kamocat/fast_charge/README.md

# fast_charge
A flexible buck buck converter for fast charging cell phones from unreliable power sources
