kamocat/fast_charge/digikey cart.xlsx

Index | Quantity | Part Number | Manufacturer Part Number | Description | Customer Reference | Available | Backorder | Unit Price | Extended Price USD
1 | 20 | RMCF0603FT30K1CT-ND | RMCF0603FT30K1 | RES 30.1K OHM 1% 1/10W 0603 |  | 20 | 0 | 0.015 | 0.30
2 | 10 | RMCF0603FT31K6CT-ND | RMCF0603FT31K6 | RES 31.6K OHM 1% 1/10W 0603 |  | 10 | 0 | 0.015 | 0.15
3 | 10 | RMCF0603FT42K2CT-ND | RMCF0603FT42K2 | RES 42.2K OHM 1% 1/10W 0603 |  | 10 | 0 | 0.015 | 0.15
4 | 10 | RMCF0603FT15K8CT-ND | RMCF0603FT15K8 | RES 15.8K OHM 1% 1/10W 0603 |  | 10 | 0 | 0.015 | 0.15
5 | 20 | RMCF0603FT158KCT-ND | RMCF0603FT158K | RES 158K OHM 1% 1/10W 0603 |  | 20 | 0 | 0.015 | 0.30
6 | 3 | 31-AP63300WU-7CT-ND | AP63300WU-7 | IC REG BUCK ADJ 3A TSOT26 |  | 3 | 0 | 0.92 | 2.76
7 | 3 | 3757-TS360ILS_R1_00001CT-ND | TS360ILS_R1_00001 | MICRO SURFACE MOUNT SCHOTTKY BRI |  | 3 | 0 | 0.58 | 1.74
8 | 15 | 4713-GMC31X7R106K50NTCT-ND | GMC31X7R106K50NT | CAP1206 X7R 10UF 10% 50V |  | 15 | 0 | 0.216 | 3.24
9 | 10 | 4816-HPC6045NC-3R3MCT-ND | HPC 6045NC-3R3M | 3.3 UH SHIELDED DRUM CORE, WIREW |  | 10 | 0 | 0.161 | 1.61
10 | 10 | RMCF0603FT390KCT-ND | RMCF0603FT390K | RES 390K OHM 1% 1/10W 0603 |  | 10 | 0 | 0.015 | 0.15
11 | 10 | RMCF0603FT4K53CT-ND | RMCF0603FT4K53 | RES 4.53K OHM 1% 1/10W 0603 |  | 10 | 0 | 0.015 | 0.15
12 | 10 | 13-PA0805FRF870R005LCT-ND | PA0805FRF870R005L | RES 0.005 OHM 1% 1W 0805 |  | 10 | 0 | 0.254 | 2.54
13 | 10 | RMCF0603FT17K4CT-ND | RMCF0603FT17K4 | RES 17.4K OHM 1% 1/10W 0603 |  | 10 | 0 | 0.015 | 0.15
14 | 10 | RMCF0603FT93K1CT-ND | RMCF0603FT93K1 | RES 93.1K OHM 1% 1/10W 0603 |  | 10 | 0 | 0.015 | 0.15
15 | 3 | 31-AP64060WU-7CT-ND | AP64060WU-7 | IC REG BUCK ADJ 600MA TSOT26 |  | 3 | 0 | 0.62 | 1.86
16 | 4 | 445-6762-1-ND | MLZ2012N100LT000 | FIXED IND 10UH 500MA 300MOHM SMD |  | 4 | 0 | 0.12 | 0.48
