kamocat/fast_charge/fast_charger.kicad_pcb

## KiCad design fast_charger.kicad_pcb (2024-04-20)

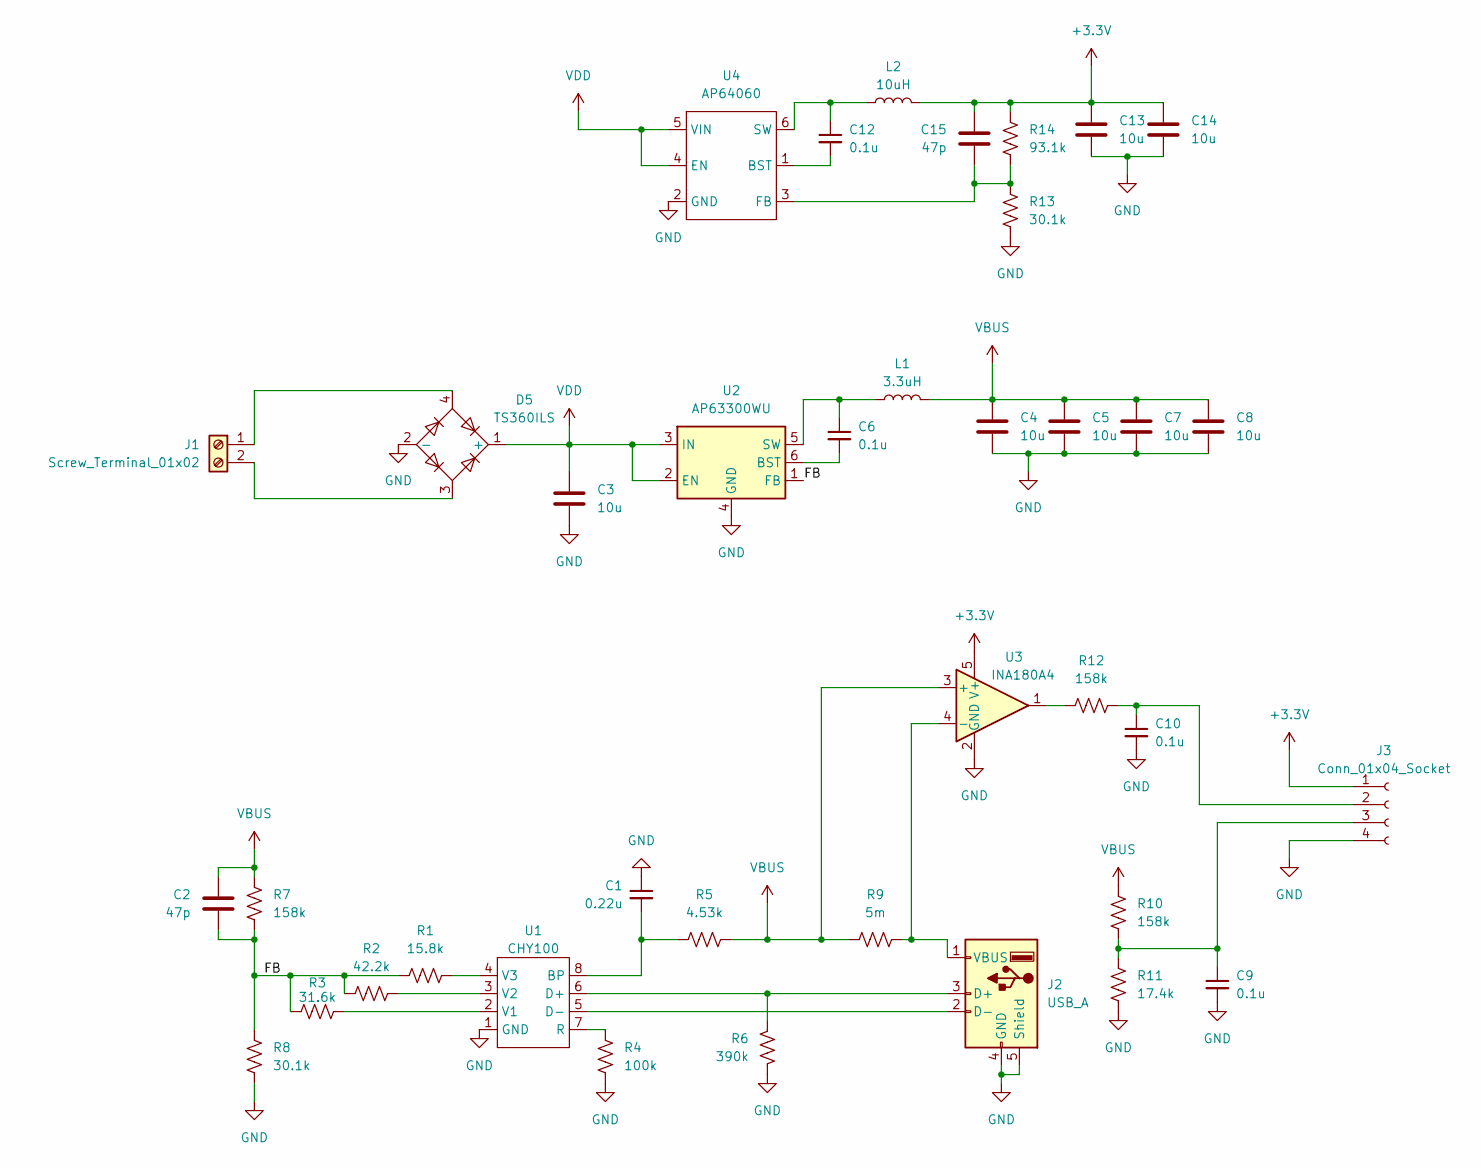
[picture p1: schematic fast_charger.kicad_sch]

Parts:
C1: 0.22u; C_0603_1608Metric
C2, C15: 47p; C_0603_1608Metric
C3, C4, C5, C7, C8: 10u; C_1206_3216Metric
C6, C9, C10, C12: 0.1u; C_0603_1608Metric
C13, C14: 10u; C_0805_2012Metric
D5: TS360ILS; TSSOP-4_4.4x5mm_P4mm
J1: Screw_Terminal_01x02; TerminalBlock_Phoenix_MKDS-3-2-5.08_1x02_P5.08mm_Horizontal
J2: USB_A; usb_CU01
J3: Conn_01x04_Socket; PinHeader_1x04_P2.54mm_Vertical
L1: 3.3uH; L_6.5x6.5
L2: 10uH; L_0805_2012Metric
R1: 15.8k; R_0603_1608Metric
R2: 42.2k; R_0603_1608Metric
R3: 31.6k; R_0603_1608Metric
R4: 100k; R_0603_1608Metric
R5: 4.53k; R_0603_1608Metric
R6: 390k; R_0603_1608Metric
R7, R10, R12: 158k; R_0603_1608Metric
R8, R13: 30.1k; R_0603_1608Metric
R9: 5m; R_0805_2012Metric
R11: 17.4k; R_0603_1608Metric
R14: 93.1k; R_0603_1608Metric
U1: CHY100; SO-8_3.9x4.9mm_P1.27mm
U2: AP63300WU; TSOT-23-6
U3: INA180A4; SOT-23-5
U4: AP64060; SOT-23-6

Connections:
+3.3V: C13.1, C14.1, C15.1, J3.1, L2.2, R14.1, U3.5 (V+)
/FB: C2.2, R1.1, R2.1, R3.1, R7.2, R8.1, U2.1 (FB)
GND: C1.1, C3.2, C4.2, C5.2, C7.2, C8.2, C9.2, C10.2, C13.2, C14.2, D5.2 (-), J2.4 (GND), J2.5 (Shield), J3.4, R4.2, R6.1, R8.2, R11.1, R13.2, U1.1 (GND), U2.4 (GND), U3.2 (GND), U4.2 (GND)
unnamed: D5.4, J1.1
unnamed: D5.3, J1.2
unnamed: J2.3 (D+), R6.2, U1.6 (D+)
unnamed: J2.2 (D-), U1.5 (D-)
unnamed: J2.1 (VBUS), R9.2, U3.4 (-)
unnamed: C10.1, J3.2, R12.2
unnamed: C9.1, J3.3, R10.2, R11.2
unnamed: R12.1, U3.1
unnamed: C1.2, R5.1, U1.8 (BP)
unnamed: R4.1, U1.7 (R)
unnamed: R3.2, U1.2 (V1)
unnamed: R2.2, U1.3 (V2)
unnamed: R1.2, U1.4 (V3)
unnamed: C6.2, U2.6 (BST)
unnamed: C6.1, L1.1, U2.5 (SW)
unnamed: C12.2, U4.1 (BST)
unnamed: C15.2, R13.1, R14.2, U4.3 (FB)
unnamed: C12.1, L2.1, U4.6 (SW)
VBUS: C2.1, C4.1, C5.1, C7.1, C8.1, L1.2, R5.2, R7.1, R9.1, R10.1, U3.3 (+)
VDD: C3.1, D5.1 (+), U2.2 (EN), U2.3 (IN), U4.4 (EN), U4.5 (VIN)

Board: 2 copper layers, 38 parts (0 on the bottom side), 23 nets, no tracks yet.
