kamocat/fast_charge/(commit log)

2023-11-05 initial schematic
    [fast_charger.kicad_pcb, fast_charger.kicad_sch]
2023-11-06 Completed BOM
    [fast_charger.kicad_sch]
2023-11-23 Completed placement
    [fast_charger.kicad_pcb, fast_charger.kicad_sch]
2023-11-25 Completed routing
    [fast_charger.kicad_pcb]
2023-11-25 V1 complete. PCB and parts ordered
    [digikey cart.xlsx, fast_charger.kicad_pcb, fast_charger.kicad_sch]
2023-12-19 Switched to AVR baremetal. PWM and ADC are working
2023-12-21 Regulates voltage ok.
    Burnt out PB2 so I'm using PB0 to drive the boost.
    I added 300 ohms inline to prevent burning out this output.
    [main.cpp]
2023-12-26 Updated LEDs for more helpful indication
2023-12-26 Added multi-rate charger. Instability comes out easily
2024-04-20 Too many issues. Moving to a simpler design
    [fast_charger.kicad_pcb, fast_charger.kicad_sch]
2024-04-20 New simpler buck-only design
    Bridge rectifier on input to allow reverse voltage
    Voltage regulation is taken care of by ASIC
    External microcontroller and OLED display show power/voltage/current
    [digikey cart.xlsx, fast_charger.kicad_pcb, fast_charger.kicad_sch]
